cmastudios/LEDDisplayBoard/README.md

Software and hardware design files for LED display board. See Project Proposal for more information.
