cmastudios/LEDDisplayBoard/CAD/RinaLEDs/Project Outputs for RinaLEDs/cad/Board4layer.step

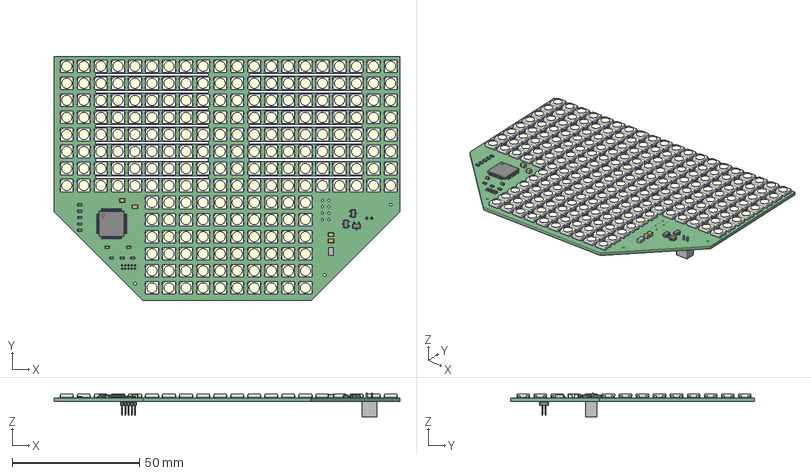
[picture p4: CAD file, 2020-12-22]
CAD/RinaLEDs/Project Outputs for RinaLEDs/cad/Board4layer.step
136.0 x 96.0 x 9.40 mm
Extruded x 4
Mid_Body x 8
Open_CASCADE_STEP_translator_6.8_19.2.1 x 16
Mark x 8
Open_CASCADE_STEP_translator_6.8_1.1.1 x 3
Leader x 73
Open_CASCADE_STEP_translator_6.8_32.1
Open_CASCADE_STEP_translator_6.8_32.2.1
User_Library-WS2812B x 220
622xxx21121_Pin x 10
622x1021121_Housing
Open_CASCADE_STEP_translator_6.8_15.1.1 x 4
Open_CASCADE_STEP_translator_6.8_15.1.2 x 4
Open_CASCADE_STEP_translator_6.8_15.2.1 x 4
Open_CASCADE_STEP_translator_6.8_18.1.1 x 2
Open_CASCADE_STEP_translator_6.8_18.1.2 x 2
Open_CASCADE_STEP_translator_6.8_18.2.1 x 2
