cmastudios/LEDDisplayBoard/CAD/RinaLEDs/RinaLEDs.pdf

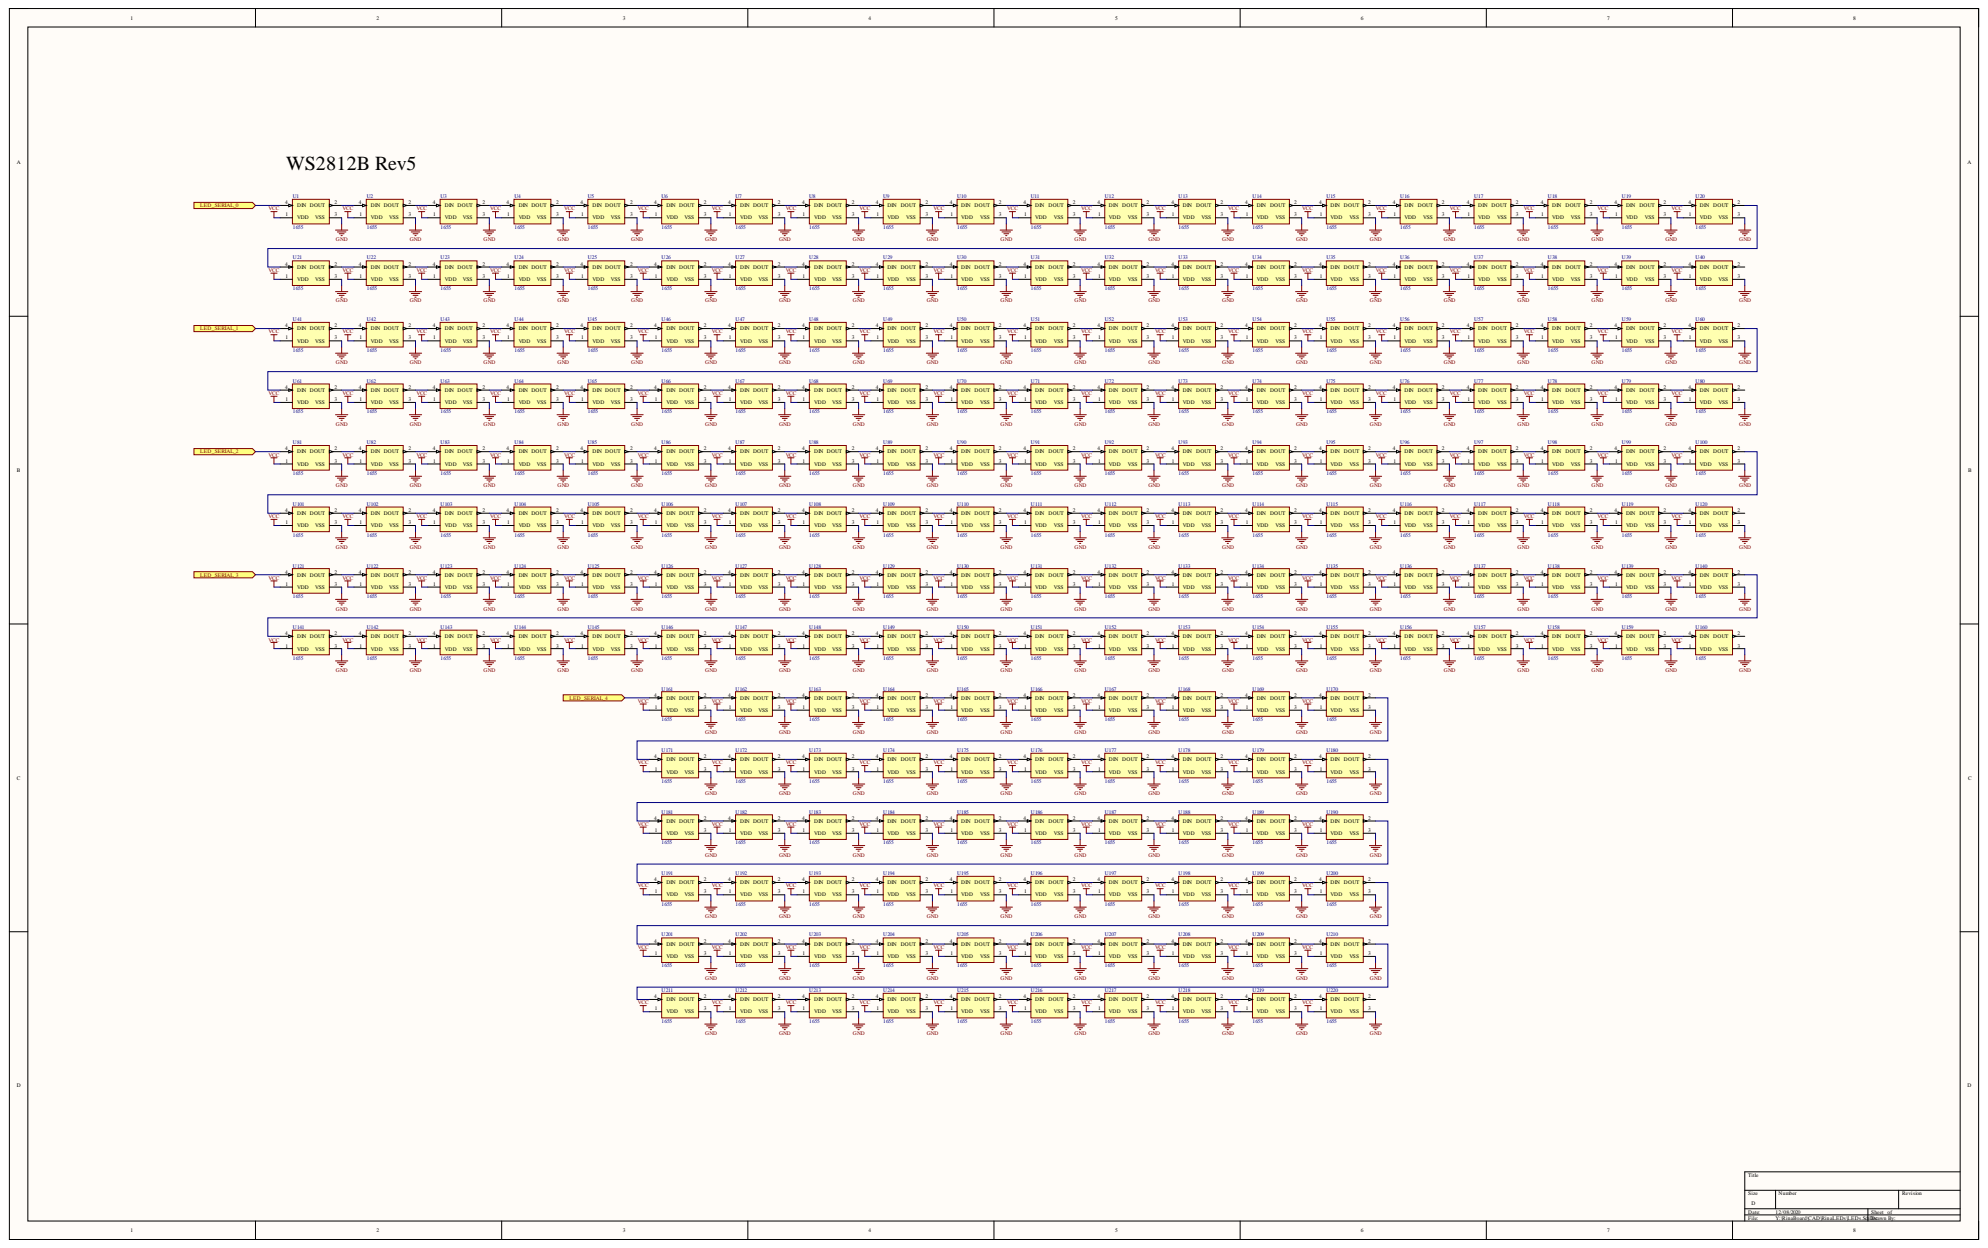
[picture p5: page 1]

Size D | Number | Revision

Date: 12/08/2020 | Sheet of

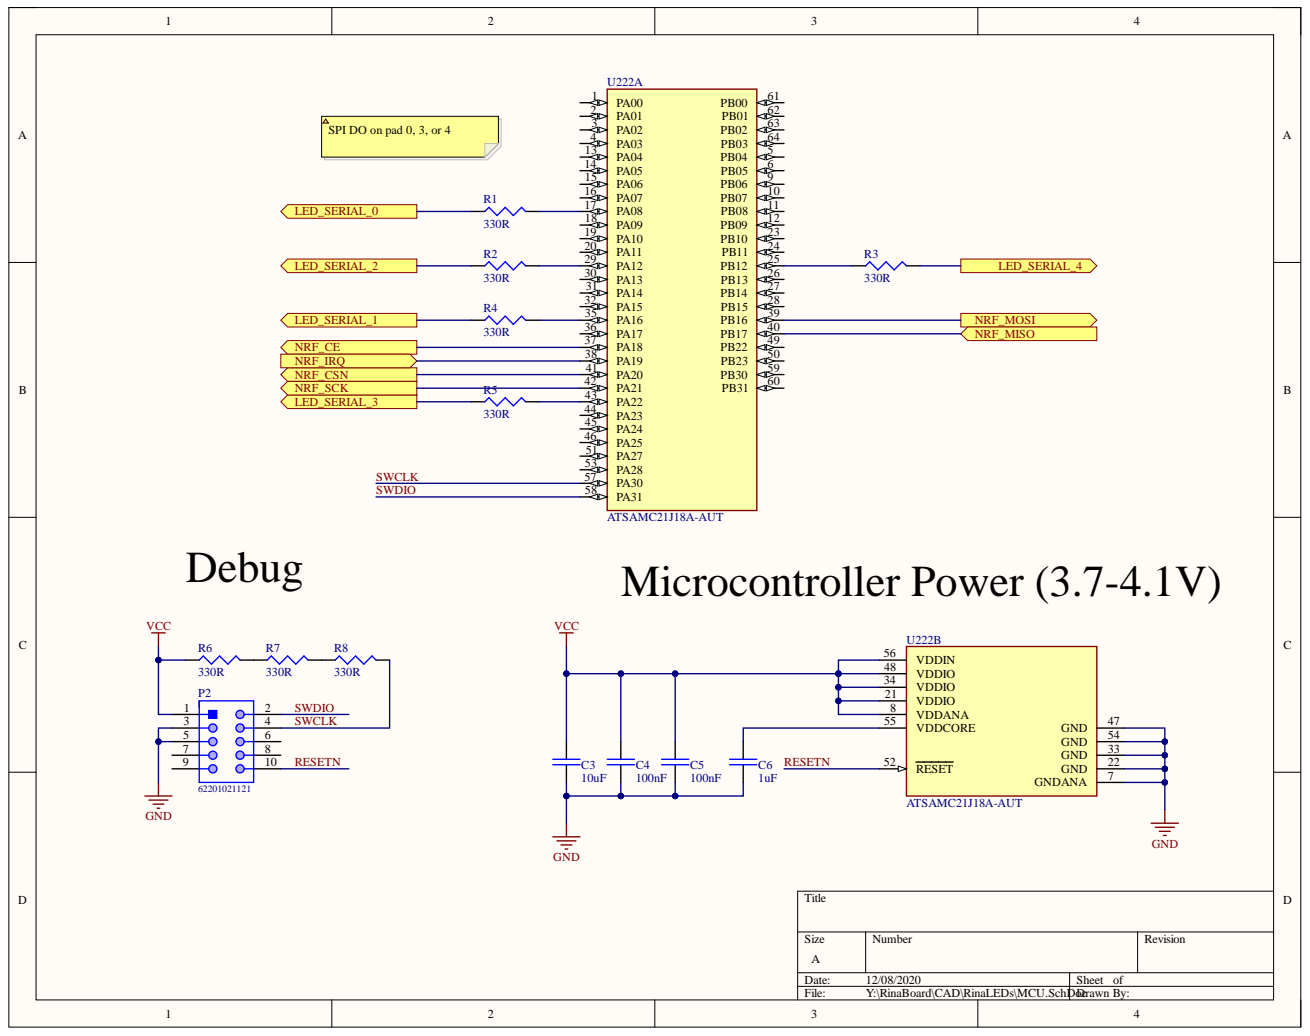
[picture p6: page 2]

SPI DO on pad 0, 3, or 4

VDDIO 48

VDDANA 8 VDDIO 21

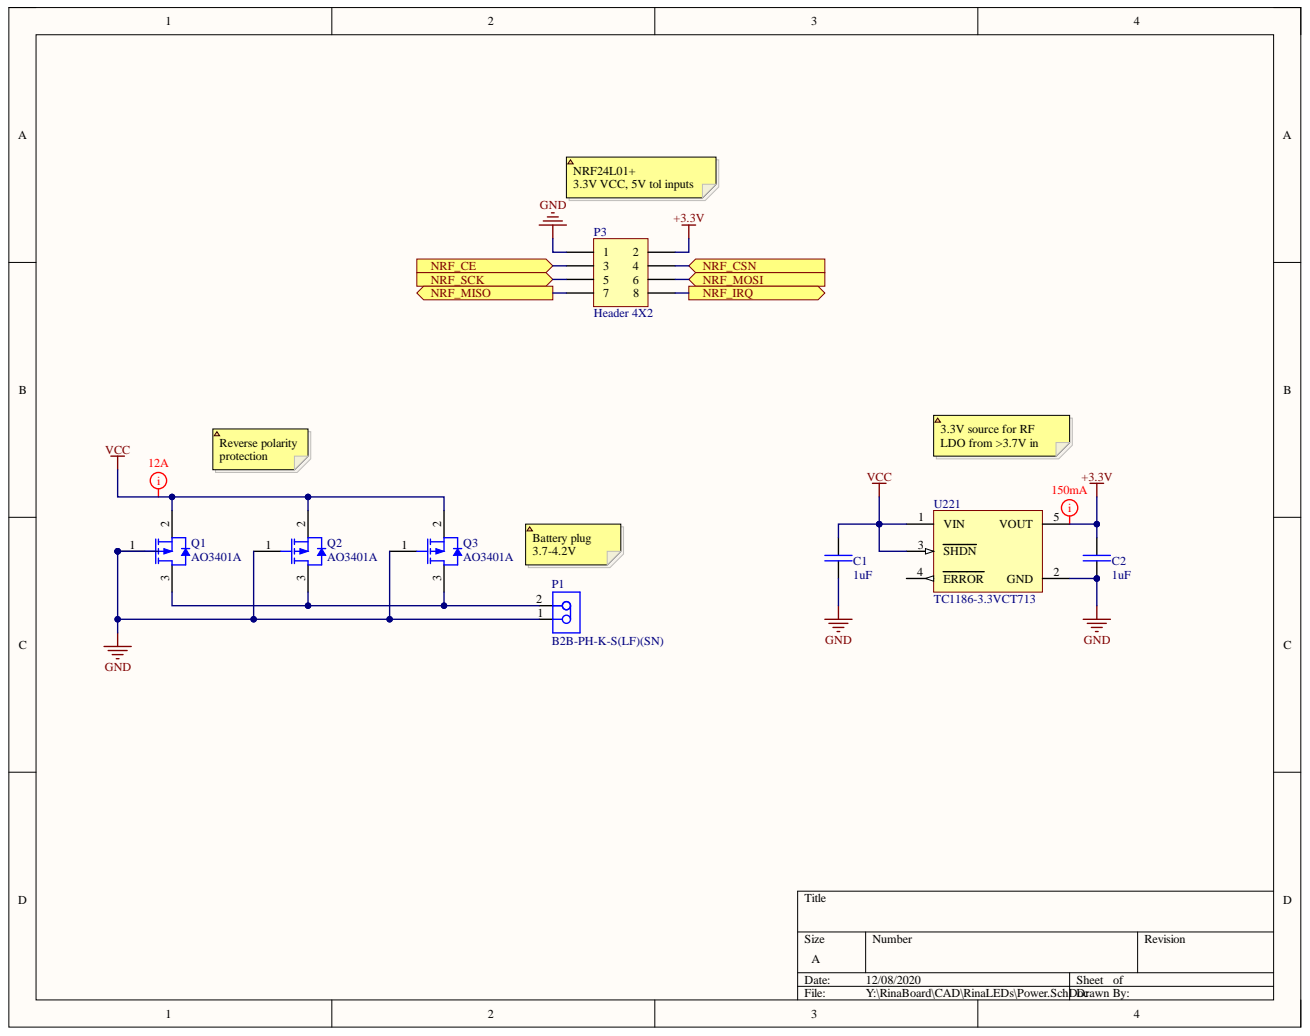
[picture p7: page 3]

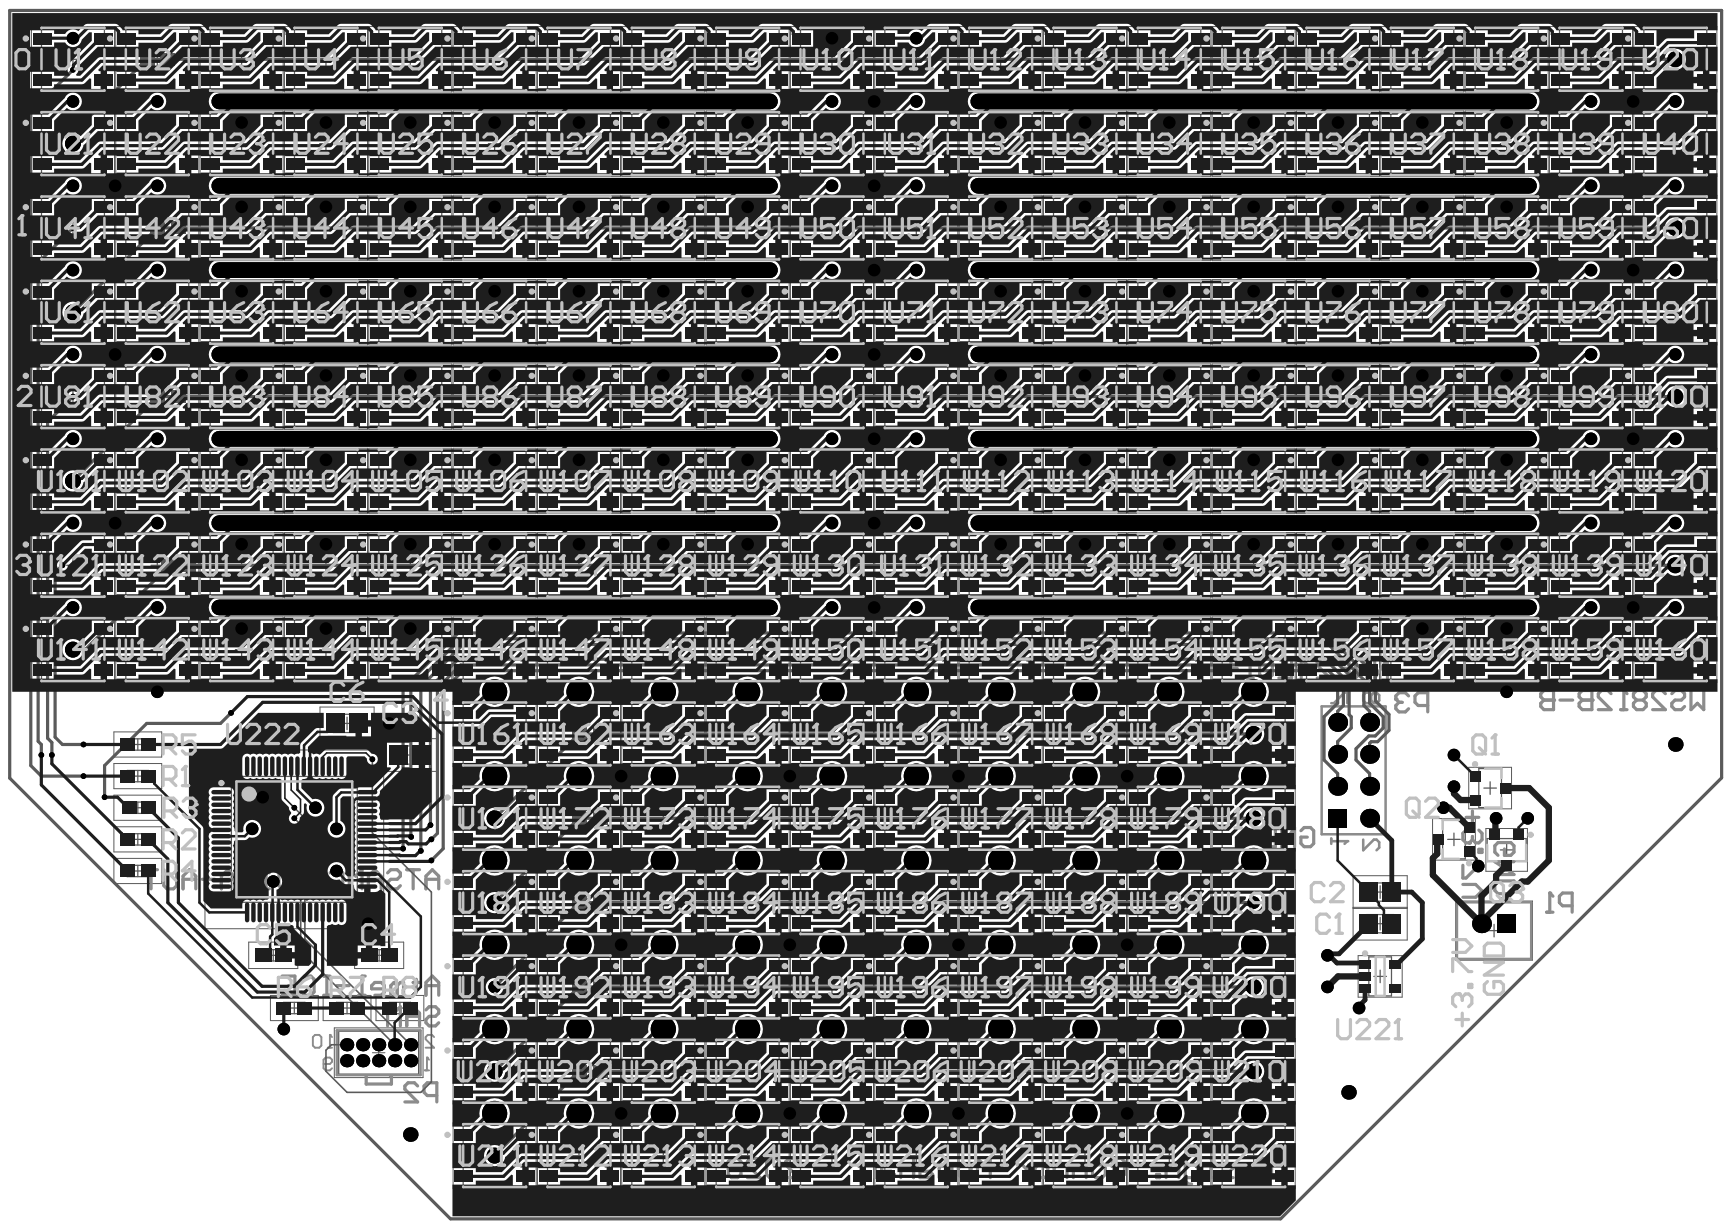
[picture p8: page 4]
