cmastudios/LEDDisplayBoard/(list of files, drawings)

Other design files:
CAD/RinaLEDs/Board4layer.PcbDoc
CAD/RinaLEDs/Display.SchDoc
CAD/RinaLEDs/LEDs.SchDoc
CAD/RinaLEDs/MCU.SchDoc
CAD/RinaLEDs/PcbLib1.PcbLib
CAD/RinaLEDs/Power.SchDoc
CAD/RinaLEDs/RinaLEDs.PrjPcb
CAD/RinaLEDs/Schlib1.SchLib
