cmastudios/LEDDisplayBoard/(commit log)

2023-06-11 battery level monitoring
2025-02-16 Build in buck2
